mahip-nicn/Open-Oxygen-Flowsensor/IMAGES/Con No SFM.jpg

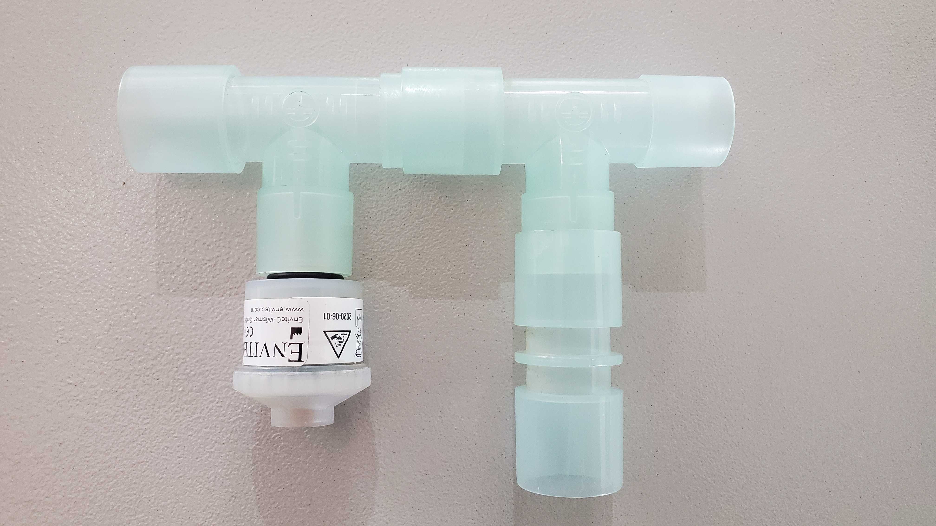
IMAGES/Con No SFM.jpg
