mahip-nicn/Open-Oxygen-Flowsensor/IMAGES/Con SFM.jpg

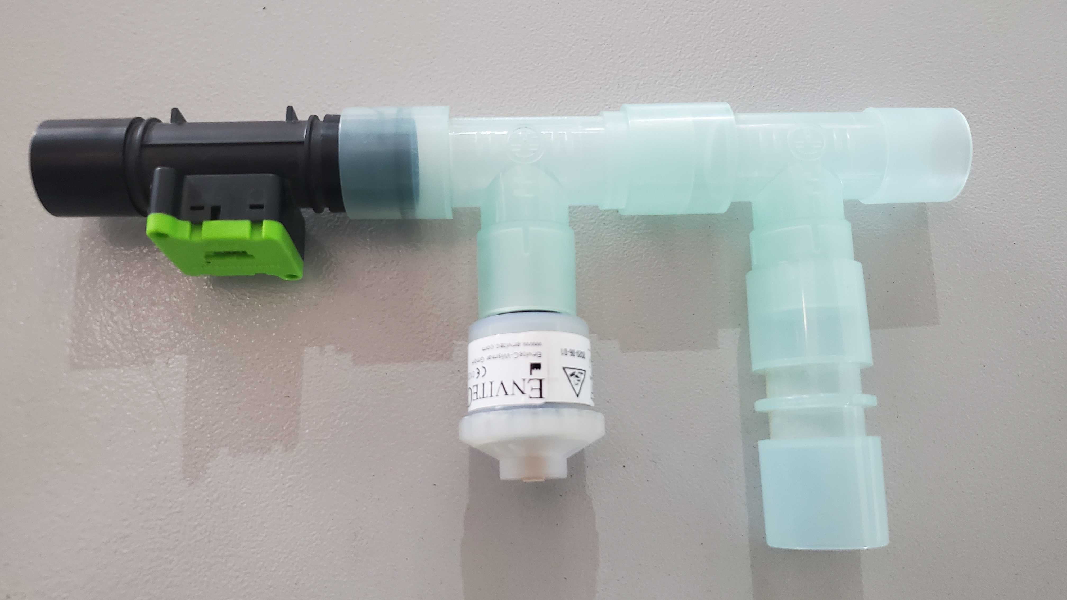
IMAGES/Con SFM.jpg
