mahip-nicn/Open-Oxygen-Flowsensor/IMAGES/Data.png

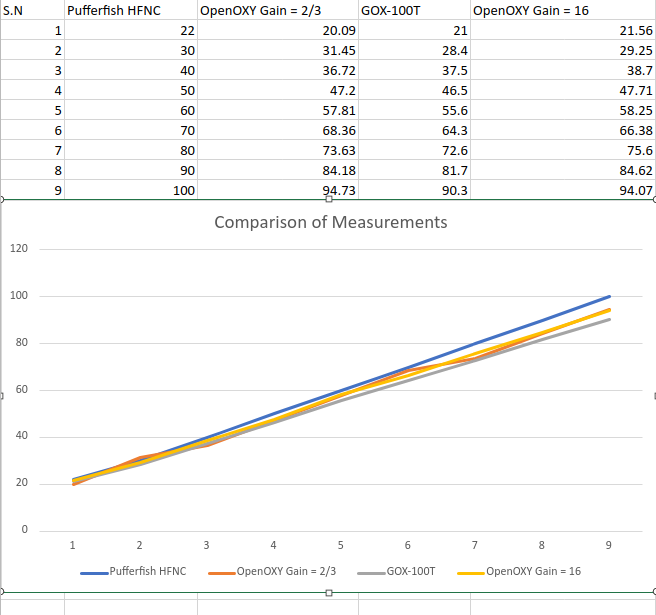
IMAGES/Data.png
