mahip-nicn/Open-Oxygen-Flowsensor/IMAGES/PEEP.jpg

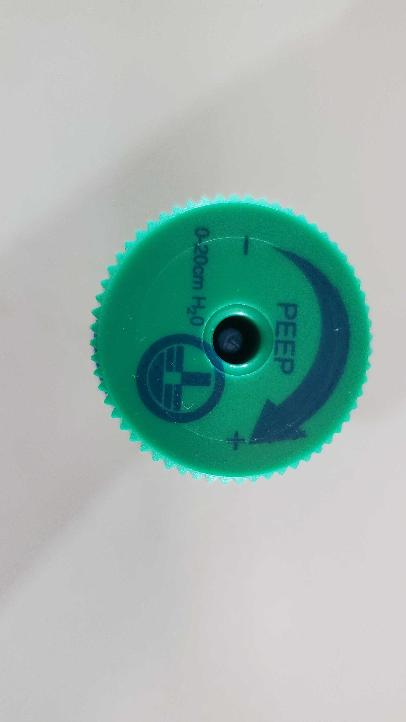
IMAGES/PEEP.jpg
