mahip-nicn/Open-Oxygen-Flowsensor/IMAGES/Peep.jpg

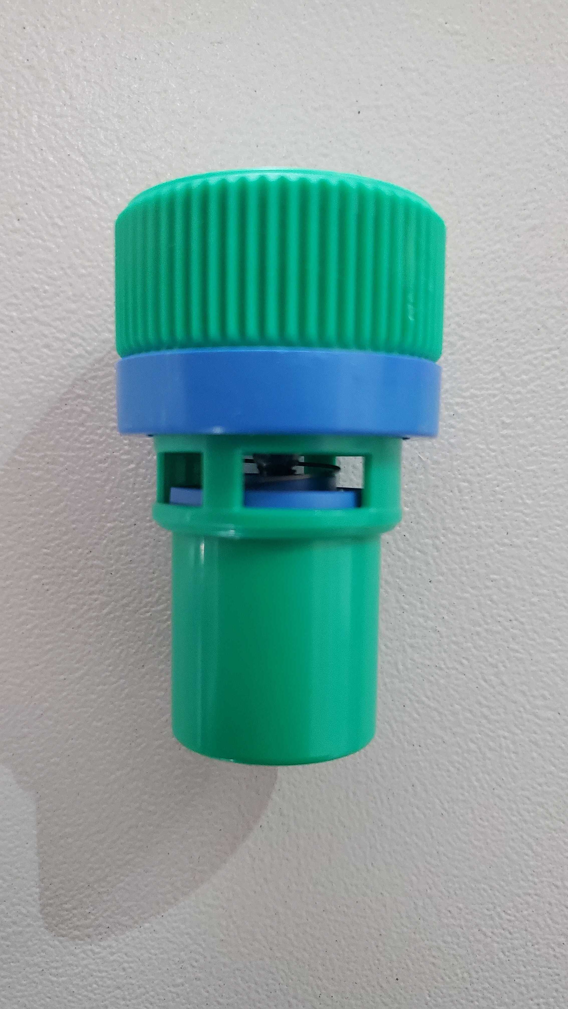
IMAGES/Peep.jpg
