mahip-nicn/Open-Oxygen-Flowsensor/DOCUMENTS/Open Oxy Proto.pdf

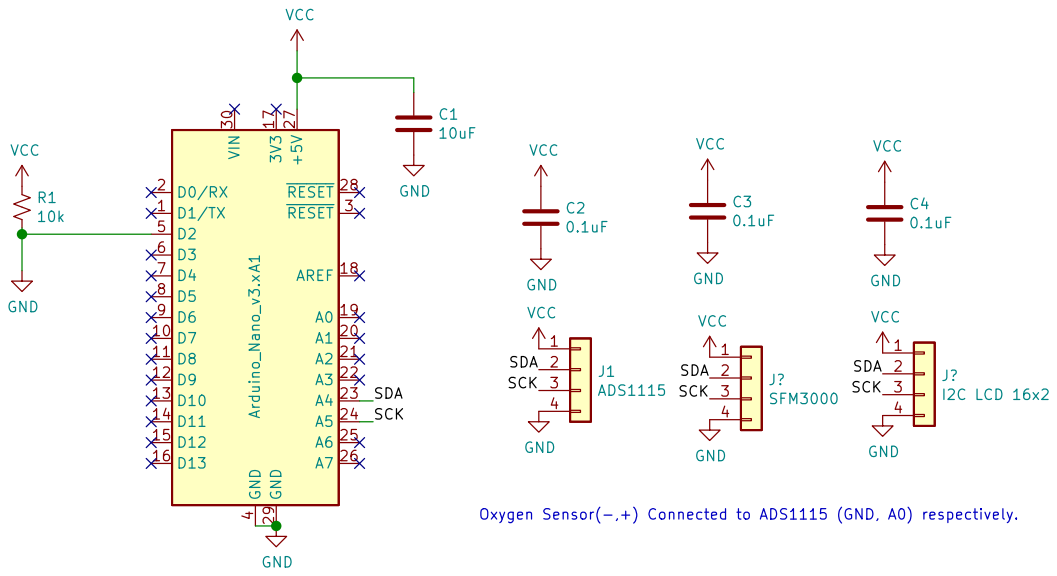
[picture p12: page 1]

SDA
SCK
SCK Oxygen Sensor(-,+) Connected to ADS1115 (GND, A0) respectively.

File: Open Oxy Proto.sch Sheet: /
Id: 1/1 Title:
