mahip-nicn/Open-Oxygen-Flowsensor/(commit log)

2021-06-12 Added libraries and calibration routine, pending test
2021-06-16 Tested, OK.
    Tested the routine. Calibrates when button is pressed at digital-pin 2 and displays the calibrated values.
2021-06-16 Data logs excel file.
    [O2_sensor_data.xlsx]
2021-06-16 Schematic Diagram.
2021-06-16 V0.1 Calibration routine
